CapSylar/65C02-SBC/(commit log)

2021-01-10 fixed overrun issues, and hex characters can now be entered as lower case
    [kernel.asm]
2021-01-25 schematic done
    [kicak_proj.kicad_pcb, kicak_proj.sch]
